mikrotron-zg/ecotron/hardware/Temp_sensor_DS18B20.dxf

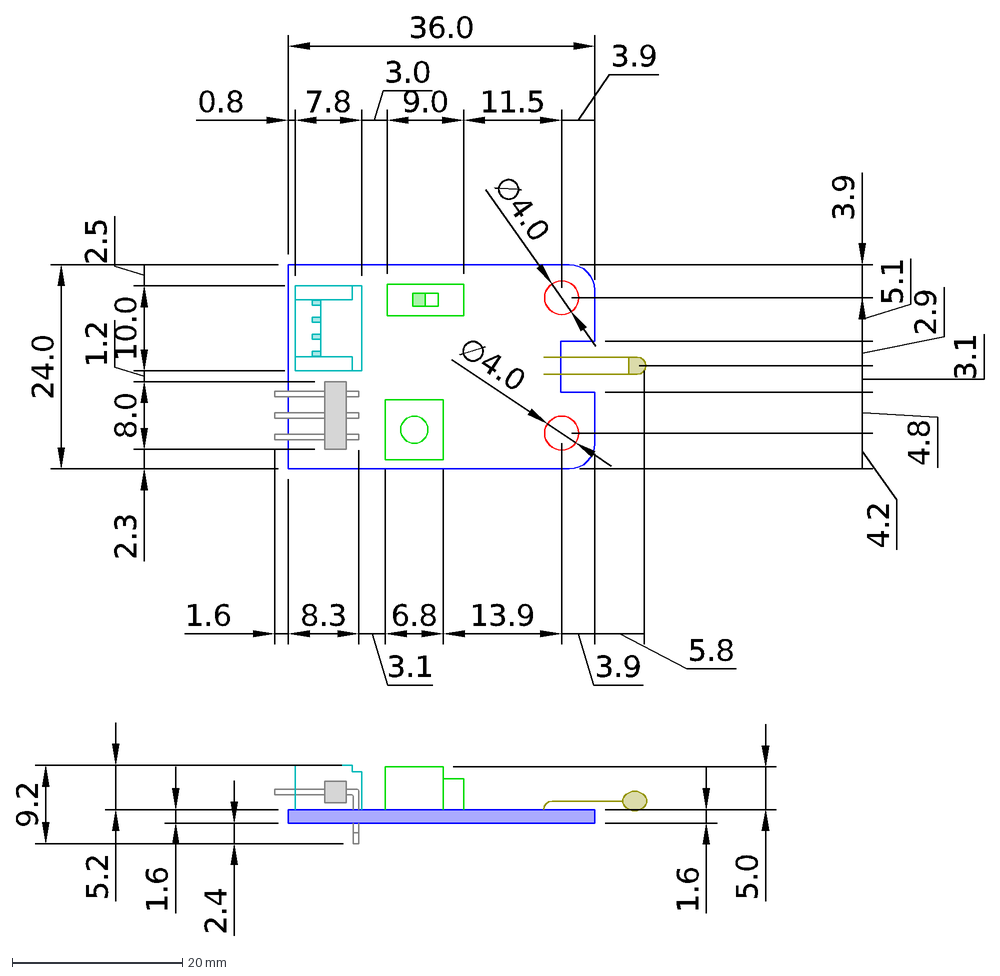
[picture p1: CAD file, 2016-08-19]
hardware/Temp_sensor_DS18B20.dxf
36.0
0.8
7.8
3.0
9.0
11.5
3.9
24.0
2.3
8.0
1.2
10.0
2.5
1.6
8.3
3.1
6.8
13.9
5.8
5.1
2.9
4.8
4.2
9.2
5.2
2.4
5.0
∅4.0
